adafruit/Adafruit-LTR-329-LTR-303-PCB/README.md

## Adafruit LTR-329 and LTR-303 Light Sensor PCBs

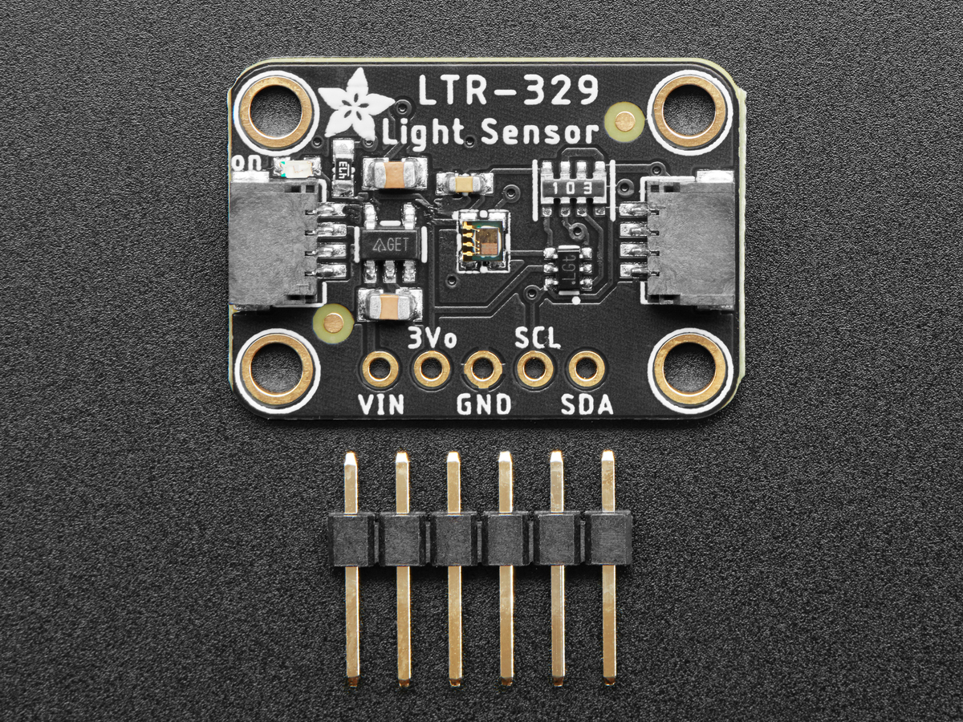
[picture p1: assets/5591.jpg]
<a href="http://www.adafruit.com/products/5591"><br/>
Click here to purchase one from the Adafruit shop</a>

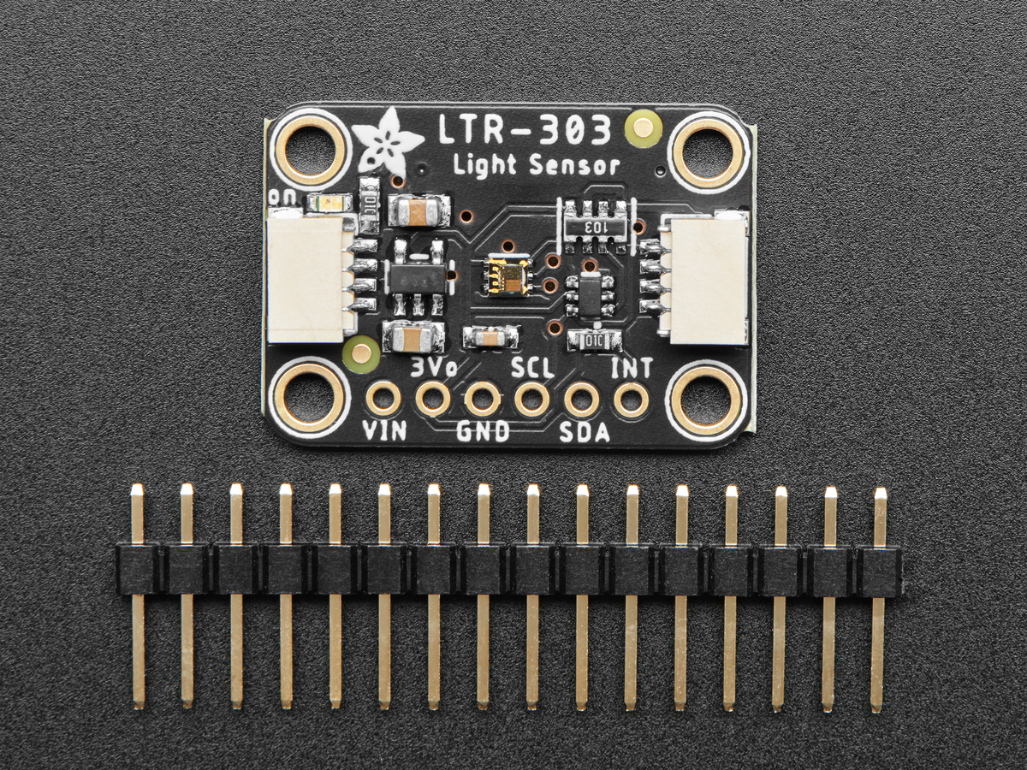
[picture p2: assets/5610.jpg]
<a href="http://www.adafruit.com/products/5610"><br/>
Click here to purchase one from the Adafruit shop</a>

PCB files for the Adafruit LTR-329 and LTR-303 Light Sensor. 

Format is EagleCAD schematic and board layout
* https://www.adafruit.com/product/5591
* https://www.adafruit.com/product/5610

### Description

The Adafruit LTR-303 and LTR-329 Light Sensors are simple and popular low-cost I2C digital light sensors that are easy to integrate into your project for reliable and wide-ranging light measurements.

Perfect for a wide range of project use cases: Should we turn up the brightness of our display or dim it to save power? Which direction should your robot move to stay in an area with the most light? Is it day or night? All of these questions can be answered with the help of the LTR-303 and LTR-329. They're small, capable and inexpensive light sensors that you can include in your next project to add the detection and measurement of light.

They provide 16-bit light measurements for both Infrared and Visible+IR spectrums. Subtract one from the other to get human-visible light. Thanks to configurable gain and integration time settings, the LTR-303 can measure from 0 to 65K+ lux.

The 303 also comes with alert and IRQ capabilities so you can have a pin trigger when the reading goes above or below threshold values. Great if you want ultra-low power usage. If you don't need a version with interrupt output, check out the LTR-329 which is basically the same sensor but without the IRQ capability.

Packaged on a PCB in our STEMMA QT form factor, the LTR-303 comes integrated with a voltage regulator and level shifting circuitry to allow it to be used with 3.3V devices, like a Feather M4 or Raspberry Pi, or 5V devices, such as an Arduino. Rather than working with the itty bitty little contacts on the sensor, the PCB it's packaged on breaks out all the pins to a standard 0.1" / 2.54mm pitch header.

### License

Adafruit invests time and resources providing this open source design, please support Adafruit and open-source hardware by purchasing products from [Adafruit](https://www.adafruit.com)!

Designed by Limor Fried/Ladyada for Adafruit Industries.

Creative Commons Attribution/Share-Alike, all text above must be included in any redistribution. 
See license.txt for additional details.
