adafruit/Adafruit-LTR-329-LTR-303-PCB/Adafruit LTR-303.brd

## EAGLE design Adafruit LTR-303.brd (2022-10-17)

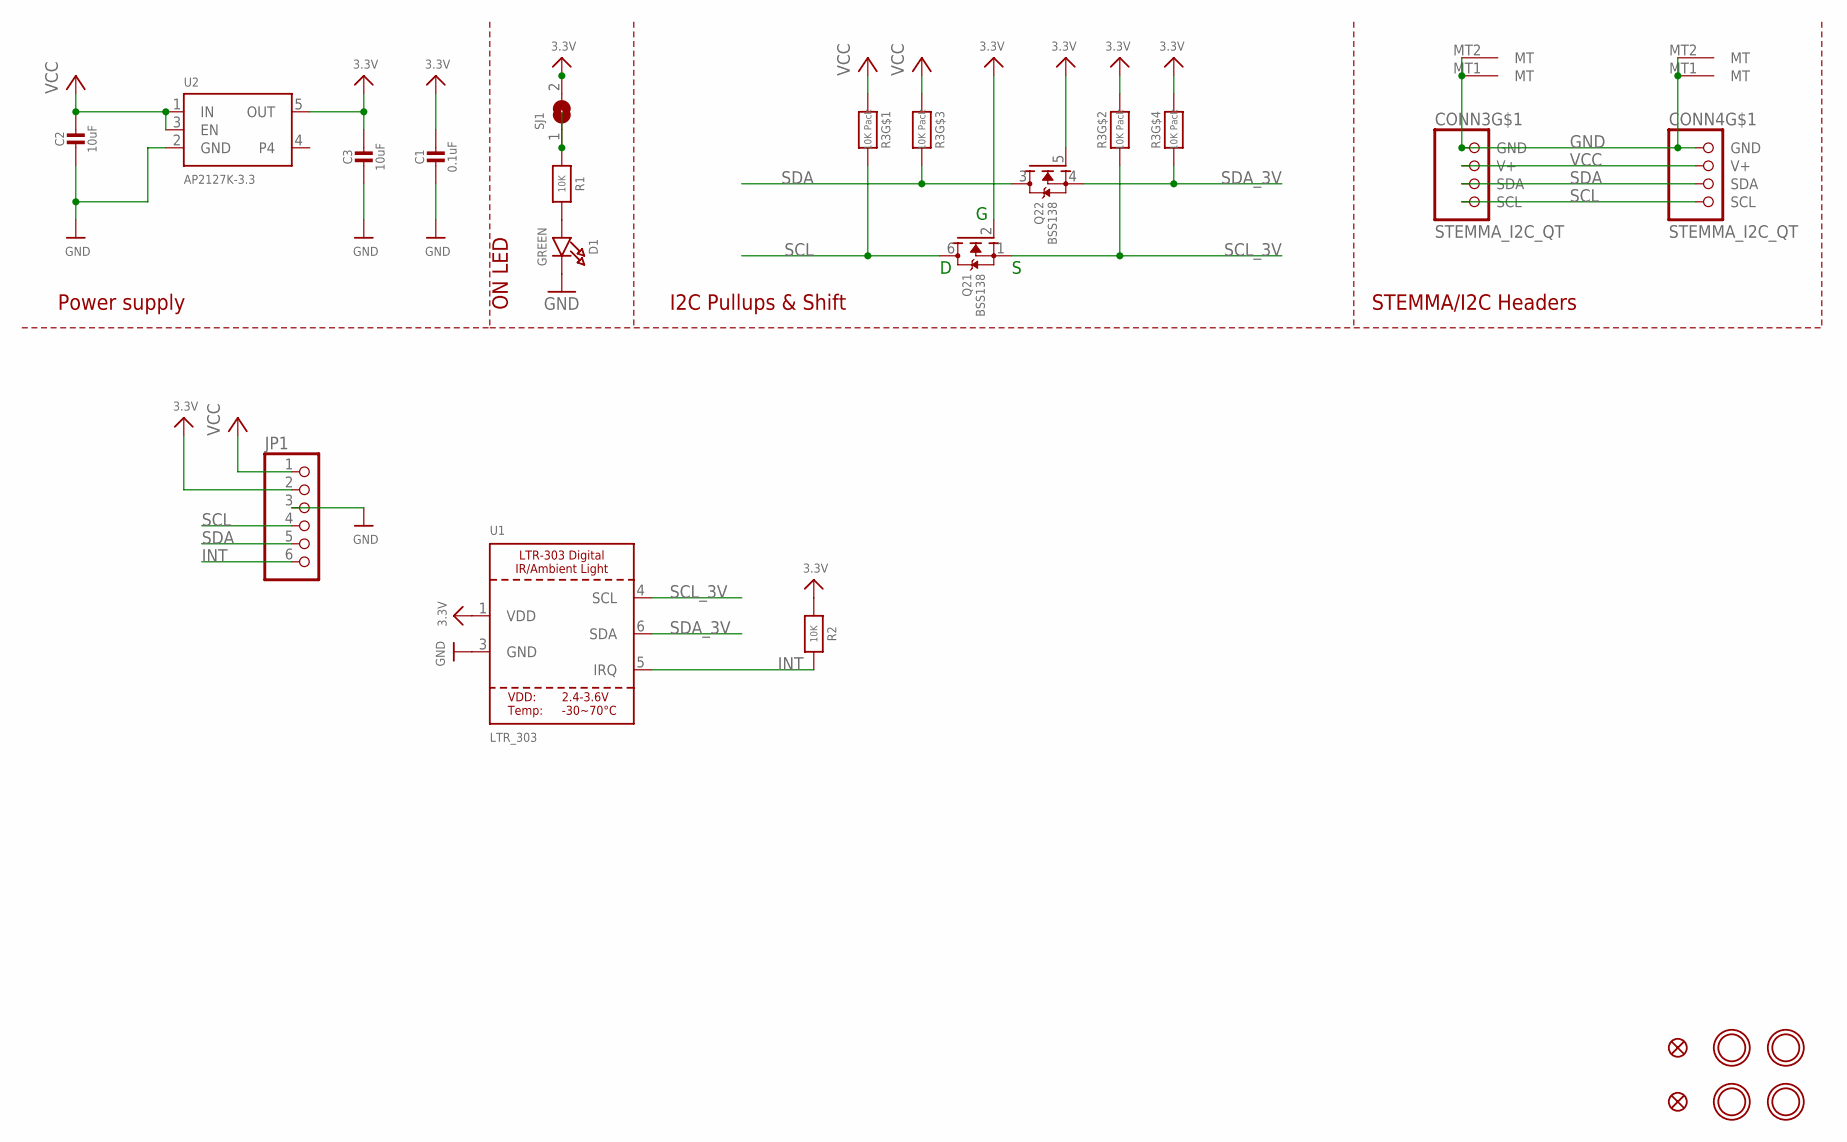
[picture p6: schematic Adafruit LTR-303.sch]

Parts:
C1: 0.1uF; 0603-NO
C2, C3: 10uF; 0805-NO
CONN3, CONN4: STEMMA_I2C_QT; JST_SH4
D1: GREEN; CHIPLED_0603_NOOUTLINE
FID3, FID4: FIDUCIAL_1MM
JP1: HEADER-1X670MIL; 1X06_ROUND_70
Q2: BSS138; SOT363
R1, R2: 10K; 0603-NO
R3: 10K Pack; RESPACK_4X0603
SJ1: SOLDERJUMPERCLOSED; SOLDERJUMPER_CLOSEDWIRE
U1: LTR_303; LTR390
U2: AP2127K-3.3; SOT23-5
U$1, U$17, U$19, U$21: MOUNTINGHOLE2.5; MOUNTINGHOLE_2.5_PLATED

Connections:
3.3V: C1.1, C3.1, JP1.2, Q2.2 (G), Q2.5 (G), R2.1, R3.2 (1), R3.4 (1), SJ1.2, U1.1 (VDD), U2.5 (OUT)
GND: C1.2, C2.2, C3.2, CONN3.1 (GND), CONN3.MT1 (MT), CONN3.MT2 (MT), CONN4.1 (GND), CONN4.MT1 (MT), CONN4.MT2 (MT), D1.C, JP1.3, U1.3 (GND), U2.2 (GND)
INT: JP1.6, R2.2, U1.5 (IRQ)
unnamed: D1.A, R1.2
unnamed: R1.1, SJ1.1
SCL: CONN3.4 (SCL), CONN4.4 (SCL), JP1.4, Q2.6 (D), R3.8 (2)
SCL_3V: Q2.1 (S), R3.7 (2), U1.4 (SCL)
SDA: CONN3.3 (SDA), CONN4.3 (SDA), JP1.5, Q2.3 (D), R3.6 (2)
SDA_3V: Q2.4 (S), R3.5 (2), U1.6 (SDA)
VCC: C2.1, CONN3.2 (V+), CONN4.2 (V+), JP1.1, R3.1, R3.3 (1), U2.1 (IN), U2.3 (EN)

Notes on the sheet:
I2C Pullups & Shift
STEMMA/I2C Headers
ON LED
Power supply

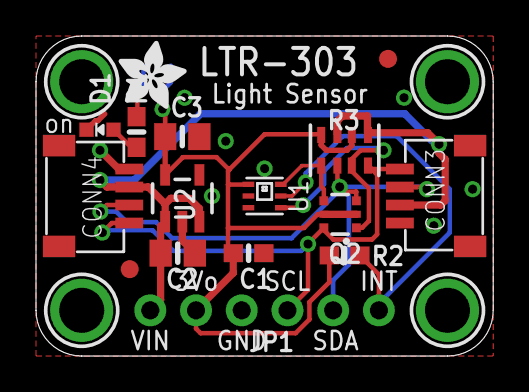
[picture p7: board Adafruit LTR-303.brd from above]

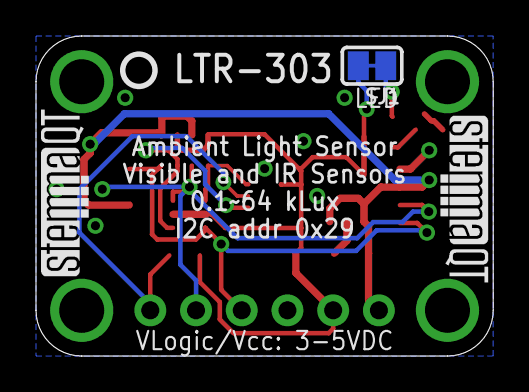
[picture p8: board Adafruit LTR-303.brd from below]

Board: 2 copper layers, 25.4 x 17.8 mm, 24 parts (4 on the bottom side), 10 nets.

Other parts of the board:
U$22: ADAFRUIT_3.5MM
U$25: PCBFEAT-REV-040
U$30, U$31: STEMMAQT
